JohnQsk/diy-midi-keyboard/diy.mechanical.midi.keyboard.md

# DIY 机械轴 MIDI 琴 方案讨论

想法：传统电子琴体积大不好存放，且非专业使用——能否用 PCB 把机械键盘轴排成一排，连电脑当琴弹？

结论：技术上完全可行（本质就是 USB MIDI 控制器），纯练习用途买二手成品更划算（见 `secondhand.buying.guide.md`），但已决定作为 DIY 项目推进。**实价调研、开源方案与已定决策见 `research.md`（2026-10）**——当前决策：25 键**单排**布局、CircuitPython 固件（不用 QMK）、固定力度+旋钮（预留双触点焊盘）、免焊原型再画 PCB。本文档保留最初的方案讨论细节。

## 整体架构

```
机械轴 → 按键矩阵 → 主控扫描 → USB MIDI (Note On/Off) → 电脑合成器发声
```

电脑端：Linux 插上后 `aconnect -l` 认出设备，QSynth 加载 SoundFont 即出声；MuseScore 也支持 MIDI 输入。

## 主控与固件（最省事的部分）

- RP2040 开发板（树莓派 Pico 或兼容板，约 ¥15~25）+ QMK 固件
- QMK 自带 MIDI 功能（`MIDI_ENABLE`），按键直接映射音符，无需自写协议
- 想用 Python：KMK（CircuitPython），同样支持 MIDI
- 参考关键词：GitHub 搜 "QMK MIDI keyboard" / "mechanical switch MIDI controller"

## 键数与布局

- 一个八度 12 键（7 白 + 5 黑）；建议至少 **25 键（两个八度）**，弹《月光》这类曲子两个八度是底线
- 真正"单排"只能按半音阶并排，靠键帽颜色区分黑白键，手感完全不像钢琴
- 更常见做法：**白键一排、黑键在上方错位半格**（高低两排，像真钢琴），1u 键帽即可实现
- 单排 25 键宽约 25×19mm ≈ 48cm

## 力度感应（机械轴最大短板）

机械轴只有通/断，没有力度（velocity），而钢琴曲表现力很大程度靠力度。选项：

| 方案 | 评价 |
|---|---|
| 固定力度（如 80） | 旋律都对但听起来"平"，弹着玩够用，**建议第一版用这个** |
| 面板旋钮实时调力度 | 半残但有点用 |
| 双触点测速 | 按下行程中两触点时间差换算速度，有开源实验，结构复杂 |
| 霍尔轴模拟量 | 成本高，不建议第一次做 |

## PCB

- KiCad 画矩阵扫描电路，每键串一个 1N4148 二极管防鬼键（全键无冲）
- 用凯华热插拔轴座，不焊轴、方便换轴
- 嘉立创打样几乎免费
- 稳妥顺序：**先洞洞板/飞线 + 开发板做 12 键原型验证软件链路**，手感能接受再画 PCB

## 成本估算（25 键版）

| 项目 | 约价 |
|---|---|
| RP2040 开发板 | ¥20 |
| 国产轴 ×25（佳达隆/高特） | ¥30~50 |
| 平胸键帽一套 | ¥30 |
| 二极管、轴座、杂件 | ¥20 |
| PCB 打样 | ¥0~30 |
| **合计** | **¥100~150** |

## 省线芯片讨论（结论：都不用，矩阵直连）

为减少 GPIO 占用考虑过三种芯片：

| 芯片 | 功能 | 结论 |
|---|---|---|
| 74HC148 优先编码器 | 8 线 → 3 线编码 | **不可用**：多键同时按只报优先级最高的一个，和弦丢音（"8线变3线"是电子琴 DIY 常见的第一直觉，坑在这） |
| 74HC138 译码器 | 3 线 → 8 线，选通行驱动 | 能省行引脚但**省不掉二极管**（鬼键是轴体共享走线的物理迂回通路，与扫描方式无关）；RP2040 引脚够用，不值得加芯片 |
| 74HC165 移位寄存器 | 8 线 → 串行，每键独立单线 | 无矩阵、无二极管、支持任意多键；速度不是瓶颈（移位微秒级，瓶颈在消抖约 5ms），代价是每键一根线 + 4 片芯片，布线比矩阵乱 |

**决定：矩阵 + 二极管直连**（25 键 5×5 仅 10 个 GPIO，标准做法，QMK/KMK 原生支持）。

## 两版 12 键原型设计（原理图/PCB 示意）

两版键位布局相同：白键 7 个一排 + 黑键 5 个上方错位半格（≈9.5mm），键心距 19.05mm，板框约 145×45mm。音符 K0..K11 → MIDI 60..71（C4..B4）。

### A. 矩阵版（3×4，首选）

- 引脚：行 GP1~GP3（输出，轮流拉低），列 GP4~GP7（输入+内部上拉）
- 每键串 1N4148，方向：**色环端（阴极）朝行线**（COL2ROW，12 个必须同向）
- PCB：F.Cu 走行线（横）、B.Cu 走列线（竖），贴片二极管 SOD-323 放背面轴脚旁
- 代码：`matrix_12key.py`（本目录，拷到 CIRCUITPY 改名 code.py）

### B. 74HC165 版（无矩阵，可扩 64 键）

- 每键独立单线：`3V3 ──[10k 上拉]──┬── 165 输入脚；轴体从输入脚到 GND`（按下=低）
- 12 键 = 2 片 165 菊花链：GP9→PL̅、GP10→CP、GP11←第1片Q7；第1片 DS←第2片 Q7；CE̅ 接 GND，每片加 100nF 退耦
- 读取：PL̅ 拉低再拉高并行锁存全部键 → 打时钟逐位移出；64 键 @1MHz 全扫描仅 64µs
- **关键优势：GPIO 恒为 3 个**，64 键 = 8 片 165 + 8 个 9 脚排阻（8×10k），RP2040-Zero 轻松带
- 上拉用排阻（8×10k 总线型）代替分立电阻，省焊点
- 成本增量极小：165 约 ¥0.5/片，排阻约 ¥0.3/个
- 代码：`hc165_12key.py`（本目录，拷到 CIRCUITPY 改名 code.py）

## 与成品对比

成品 25 键 MIDI 键盘（如 midiplus AKM320）约 ¥200+，**自带力度感应**。DIY 打不过性价比，赢面在：好玩、布局完全自定义、可魔改（屏幕显示当前音符、错题检测等）。目的是练曲子 → 买成品；动机是造一个自己的琴 → 值得做。

## 原型进展

### 2026-10-19 单键链路验证（通过）

- 硬件：RP2040-Zero + 1 个轴体，接线 GP1 ↔ 轴体 ↔ GND（内部上拉，单键无需电阻/二极管）
- 固件：CircuitPython 9.2.9（waveshare_rp2040_zero 版），`adafruit_midi` 库发 Note On/Off（中央 C，固定力度 80）
- 验证：`aconnect -l` 识别为 ALSA MIDI 设备；`aseqdump -p 20:0` 抓到干净的 Note On/Off 配对，无连发无丢失
- 监控工具：`keydash.py`（本目录，终端仪表盘，读 `/dev/ttyACM0` 实时显示按键状态/时长/次数）
- 尚未验证：电脑端实际发声（需装 fluidsynth + SoundFont）
- 下一步：飞线搭 12 键原型（两版代码已备好：`matrix_12key.py` / `hc165_12key.py`），验证和弦无鬼键后再画 PCB
