JohnQsk/diy-midi-keyboard/matrix_12key_schematic.png

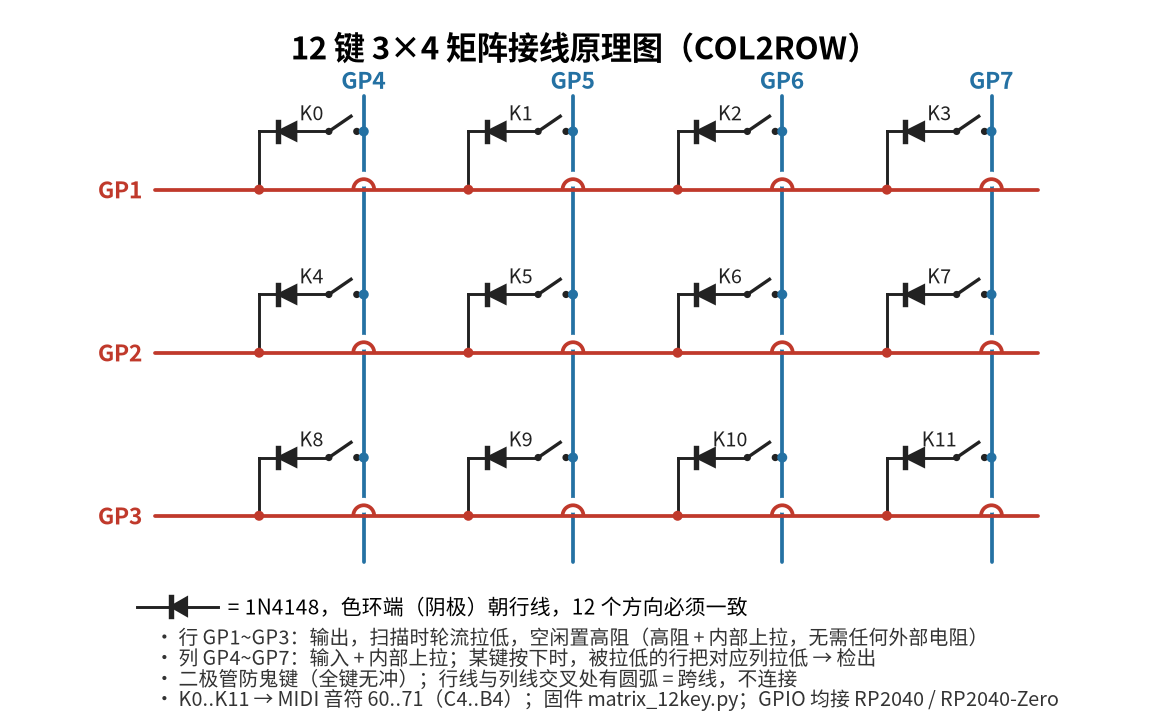
matrix_12key_schematic.png
