JohnQsk/diy-midi-keyboard/module_1x4_concept.png

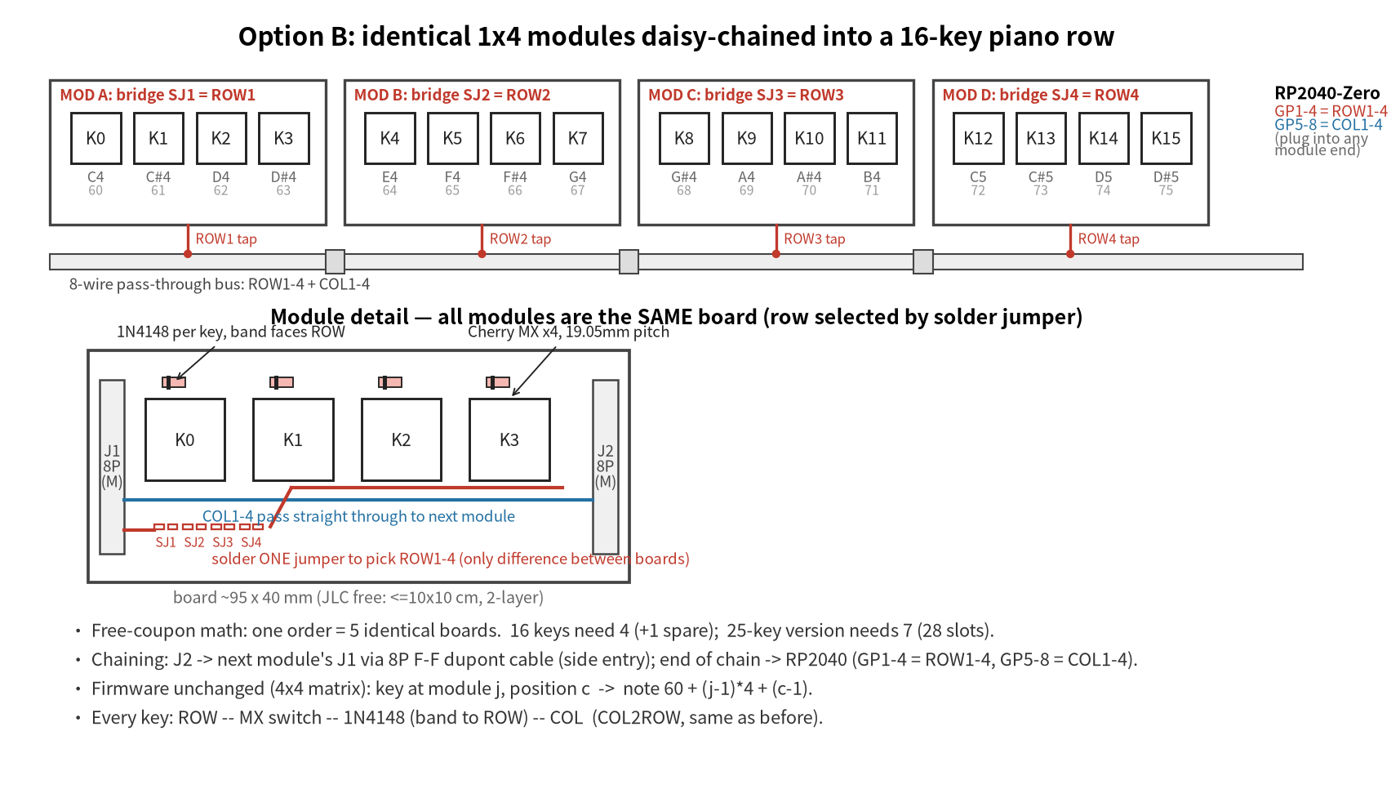
module_1x4_concept.png
