JohnQsk/diy-midi-keyboard/module_1x4_easyeda.png

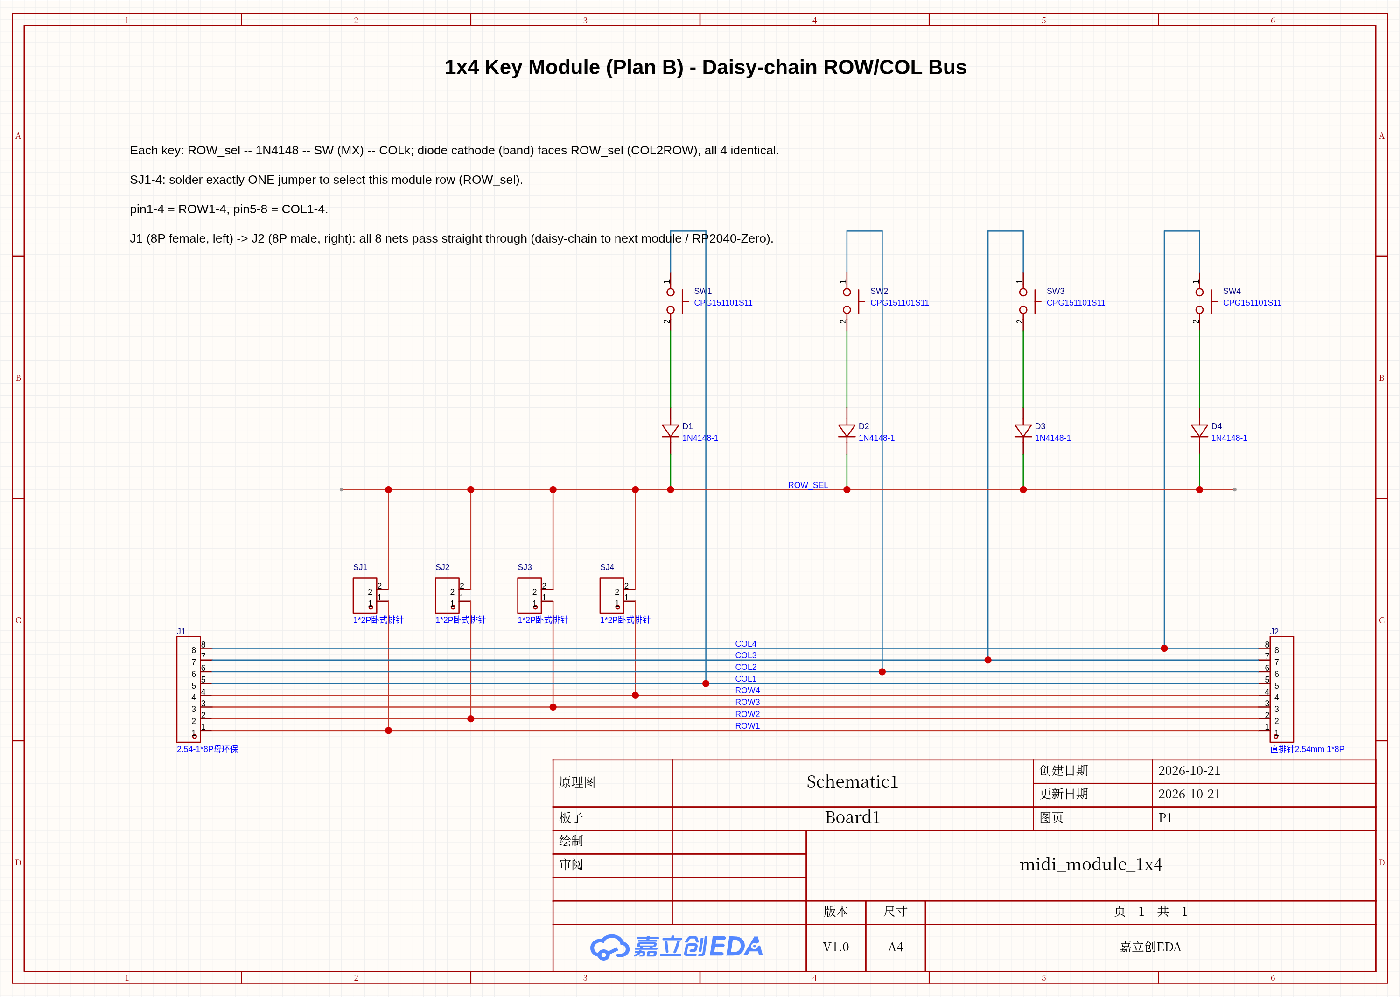
module_1x4_easyeda.png
