JohnQsk/diy-midi-keyboard/module_1x4_easyeda_pcb.png

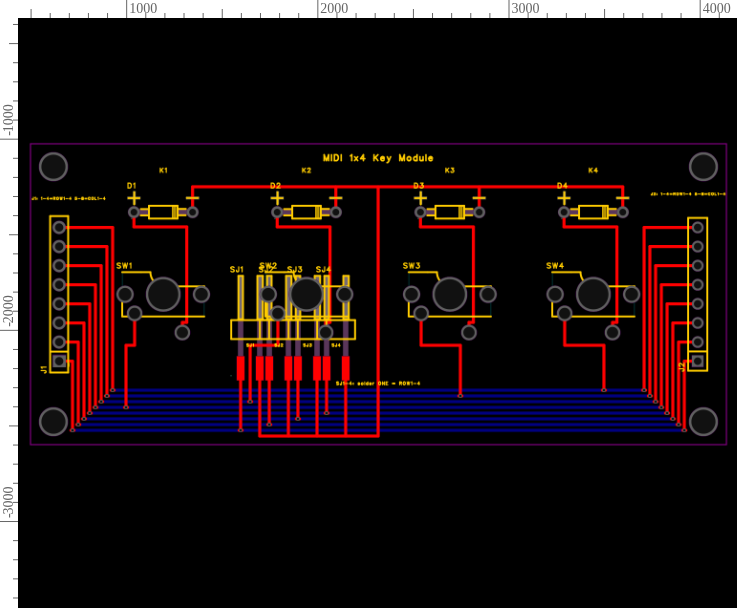
module_1x4_easyeda_pcb.png
