JohnQsk/diy-midi-keyboard/module_1x4_schematic.png

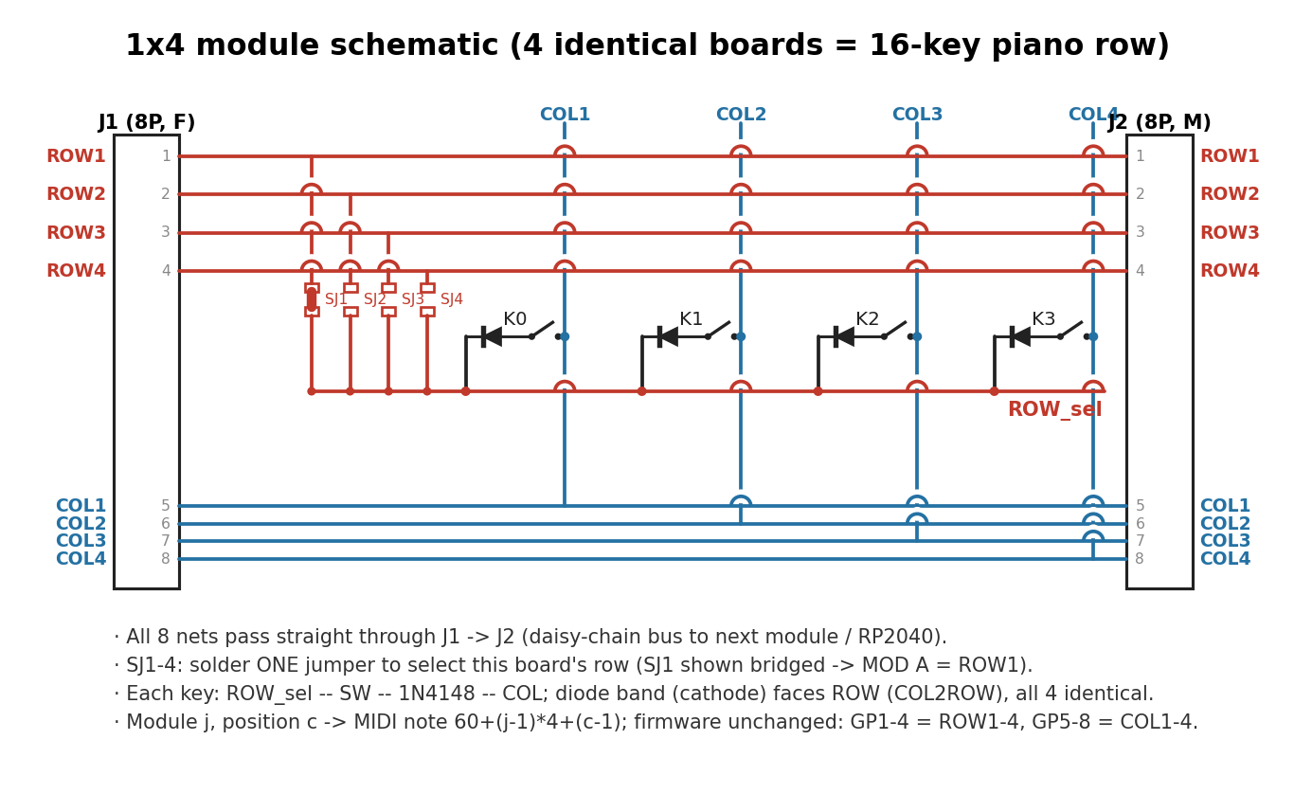
module_1x4_schematic.png
