JohnQsk/diy-midi-keyboard/secondhand.buying.guide.md

# 二手 MIDI 键盘选购指南（闲鱼）

结论：练习用（看谱弹《月光》这类曲子），闲鱼买二手 MIDI 键盘比 DIY 划算——自带力度感应，即插即用。

## 档位选择

**看着谱弹着玩 + 熟悉键盘：25~49 键 MIDI 控制器**

- 搜索关键词：`MIDI键盘`、`midiplus`、`Keystation`、`M-Audio`、`Nektar`
- 经典型号：midiplus AKM320（25 键）、M-Audio Keystation 49/61、Nektar SE49
- 闲鱼参考价：25 键 ¥80~150；49 键 ¥150~300；61 键 ¥200~400
- 都带力度感应，USB 直插

**认真练钢琴（手型指法按钢琴来）：88 键电钢琴**

- 雅马哈 P 系列、罗兰 FP 系列二手 ¥1000~2500，重锤键盘手感接近真钢
- 缺点：长约 1.3 米，存放要想清楚

**折中：61 键半配重 MIDI 键盘**，几十厘米长，可立起来塞柜子缝，兼顾存放和够用。

## 验货要点（面交或让卖家拍视频）

1. **每个键都按一遍**——听有没有不响的、连击的（二手最常见问题）
2. 试力度感应：轻按和重按音量有没有明显区别
3. 看 USB 口有没有松动，插电脑能不能直接认出来
4. 旋钮、推子、八度切换键（OCTAVE ±）都试一下
5. 砍价理由：缺原装线、成色、老型号

## 配合 Ubuntu 使用

MIDI 键盘基本都是标准 USB-MIDI 类设备，Linux **免驱即插即用**：

```bash
aconnect -l   # 确认识别
```

- QSynth 加载钢琴 SoundFont 即可弹着听
- 接进 MuseScore：Edit → Preferences → Note Input 里选 MIDI 输入设备，可边弹边录入音符
- 常见问题（识别不了、没声音、延迟大）都是几分钟能调好的，遇到再查
