JohnQsk/diy-midi-keyboard/module_wiring.png

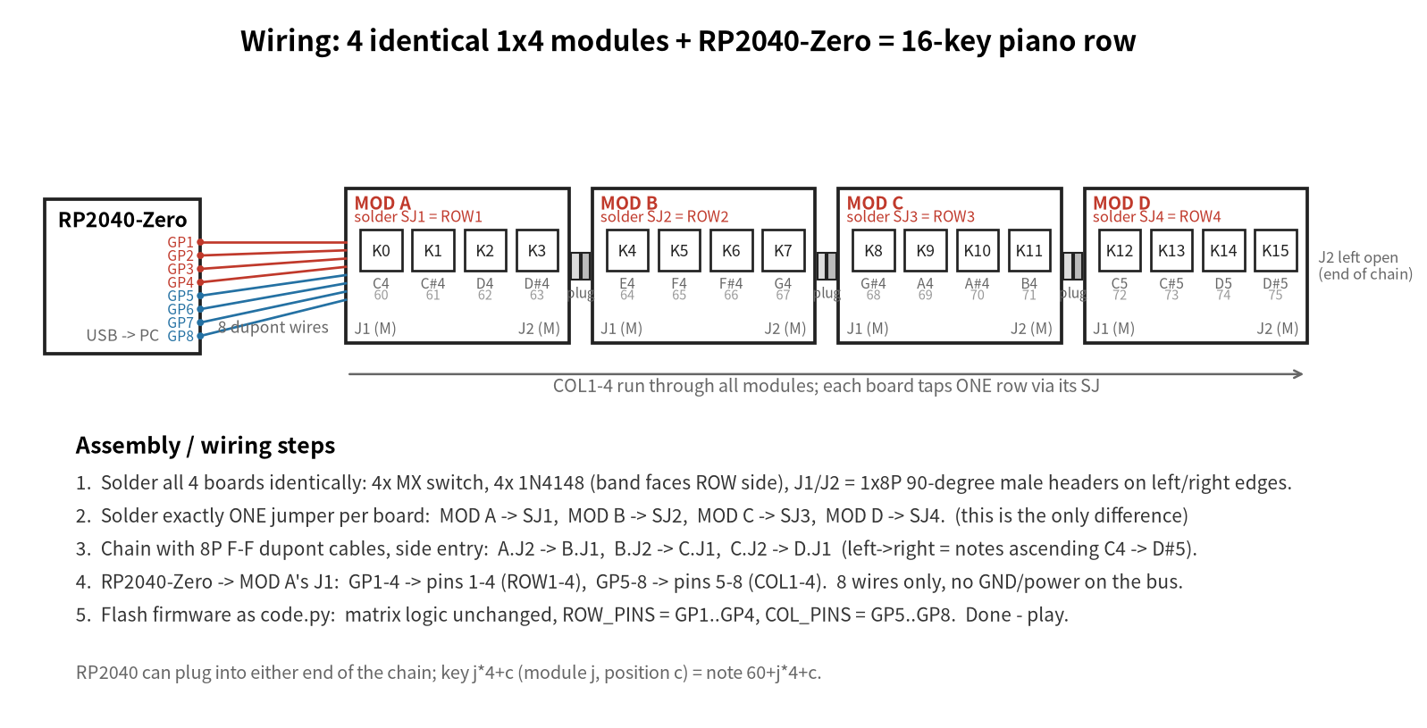
module_wiring.png
