JohnQsk/diy-midi-keyboard/CHANGELOG.md

# 更新日志

## v0.2（2026-10-21）

方案 B 模块 PCB 改版：J1/J2 从底部横放改为左右两侧板边竖放。

- 板宽 76.2 → 92.5×40mm，两侧各留 320mil 边距放级联接口；代价：模块接缝处键距约 35.3mm（不再是键距整数倍，接缝有明显缝隙）
- J1/J2 旋转 90° 竖放于板边中央，实际焊接用 90° 弯针公头（焊盘与直针相同，封装不变），级联改用 8P F-F 杜邦线侧面水平对插
- 布线重做：8 条直通总线底层横走（按 J1 实测焊盘位置自适应分配），两侧顶层 90° 扇出下接；ROW_SEL 改全顶层走线（y=45 走廊 → x=1820 上升通道 → y=1350 汇流排）
- 过孔改 12/20mil（实测 DRC 按孔+盘=Ø32mil 有效直径算间距）；DRC 0 违规
- 同步更新 module_wiring / module_1x4_concept 示意图与 AGENTS.md

## v0.1（2026-10-21）

首个可用基线（合并此前全部 backup 提交）。

- CircuitPython 固件两版：`matrix_12key.py`（3×4 矩阵，首选）、`hc165_12key.py`（74HC165 备选）
- 电脑端工具：`keydash.py` 串口仪表盘 + 各示意图/工程生成器
- KiCad 工程：12 键 3×4 矩阵原理图、16 键单排钢琴布局 PCB（电气 4×4 矩阵）
- 嘉立创 EDA 方案 B 模块：1×4 键原理图 + PCB（76.2×40mm，J1/J2 底部横放，跨模块键距连续）
- 单键链路已在真硬件验证（RP2040-Zero + 1 轴，aseqdump 抓到干净 Note On/Off）
