JohnQsk/diy-midi-keyboard/(commit log)

2026-10-19 Initial commit: DIY mechanical-switch MIDI keyboard project
2026-10-21 v0.1: 12 键原型链路 + 方案 B 模块（底部横放级联）基线
    [midi_matrix.kicad_sch, midi_matrix_4x4.kicad_pcb]
2026-10-21 v0.2: 方案 B 模块 PCB 改版——J1/J2 侧放板边，板宽 92.5mm
2026-10-26 v0.3: 16 键矩阵固件 + PCB 组装接线 README；模块板三键全链路发声验证通过
