JohnQsk/diy-midi-keyboard/(notices)

Notices in the files:
research.md:
开源验证先例：Melodicade MX（完整构建指南 + GPL3 代码）；霍尔路线见 [PJRC 论坛项目](https://forum.pjrc.com/index.php?threads/velocity-sensitive-contactless-midi-keyboard-with-polyphonic-aftertouch-for-teensy-synth.75078/) 和 Midihex。
